jamarju/dump_spi_flash/cube/README.md

[STM32CubeMX](http://www.st.com/content/st_com/en/products/development-tools/software-development-tools/stm32-software-development-tools/stm32-configurators-and-code-generators/st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) project for my STM32F103C8T6 SPI NOR flash programmer.

Includes:

* Pinout
* Clock config

This was **not** used to generate the skeleton project, only to sketch out the pinout.
