jamarju/dump_spi_flash/cube/pin_assignment_screenshot.png

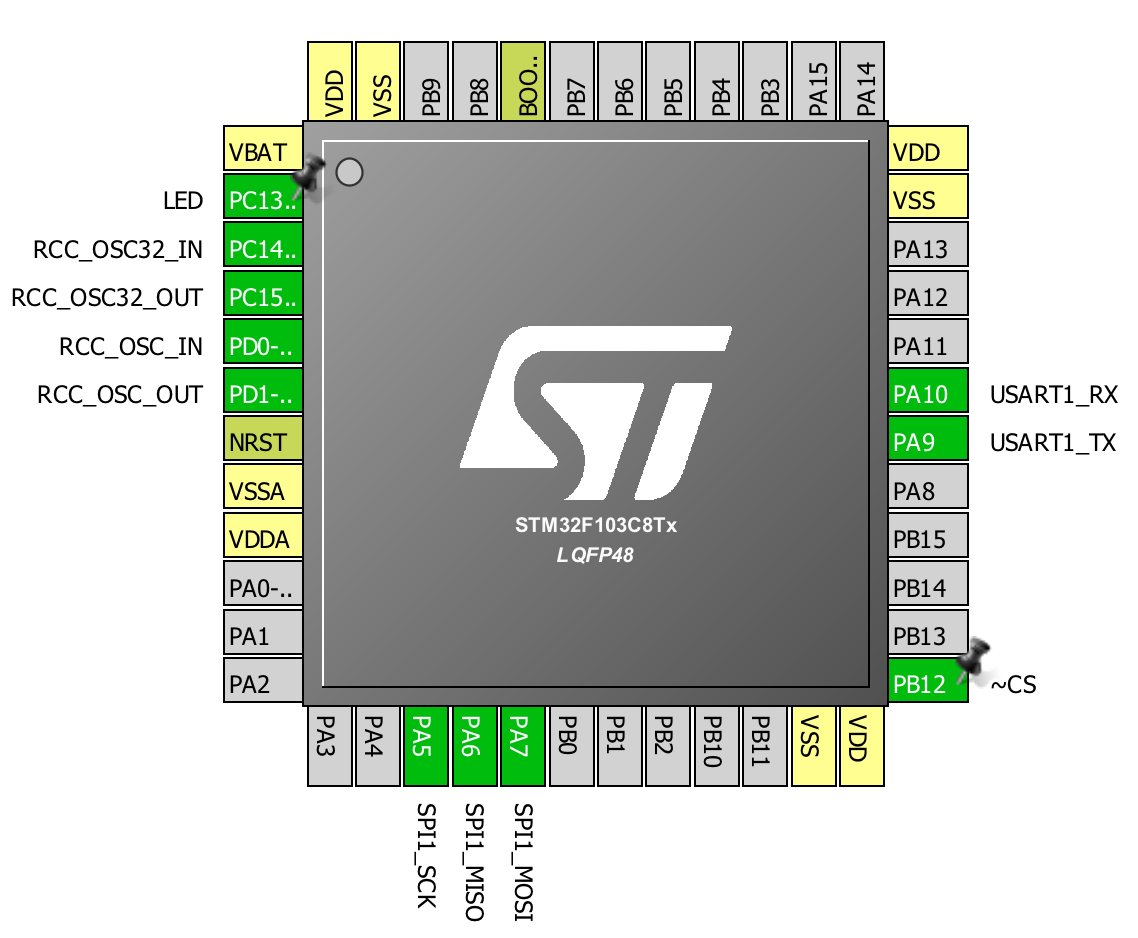
cube/pin_assignment_screenshot.png
