jamarju/dump_spi_flash/photos/ghetto_prog_02.jpg

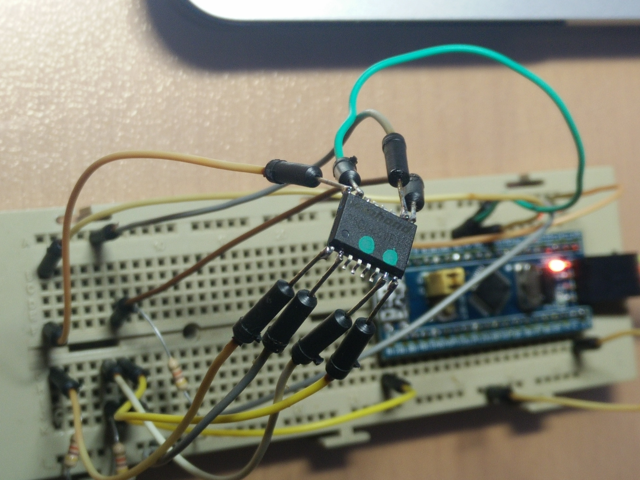
photos/ghetto_prog_02.jpg
