jamarju/dump_spi_flash/schematic/25Q64CVFIG programmer.sch

## KiCad design schematic/25Q64CVFIG programmer.sch (2016-08-23)

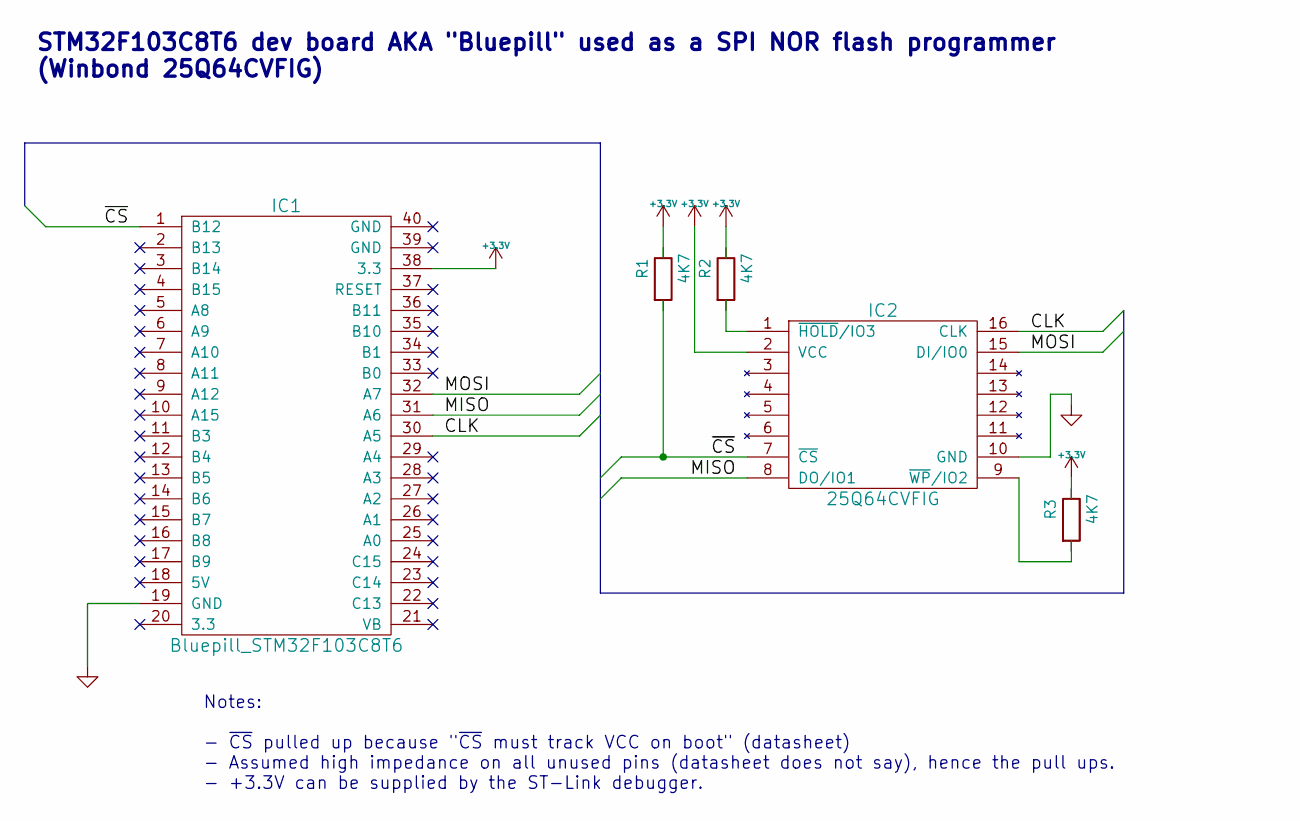
[picture p7: schematic 25Q64CVFIG programmer.sch]

Parts:
IC1: Bluepill_STM32F103C8T6
IC2: 25Q64CVFIG
R1, R2, R3: 4K7

Connections:
+3.3V: IC1.38 (3.3), IC2.2 (VCC)
CLK: IC1.30 (A5), IC2.16 (CLK)
GND: IC1.19 (GND), IC2.10 (GND)
MISO: IC1.31 (A6), IC2.8 (DO/IO1)
MOSI: IC1.32 (A7), IC2.15 (DI/IO0)
~CS: IC1.1 (B12), IC2.7 (~CS)

Notes on the sheet:
Notes: - ~CS~ pulled up because "~CS~ must track VCC on boot" (datasheet) - Assumed high impedance on all unused pins (datasheet does not say), hence the pull ups. - +3.3V can be supplied by the ST-Link debugger.
STM32F103C8T6 dev board AKA "Bluepill" used as a SPI NOR flash programmer (Winbond 25Q64CVFIG)
