jamarju/dump_spi_flash/(commit log)

2016-08-23 SPI NOR flash dumper eclipse project
2016-08-23 bluepill programmer kicad schematic + svg
    [25Q64CVFIG programmer.sch]
2016-08-23 added stm32f10x_spi.c to the Release config + .gitignore /Release
2016-08-23 added openocd and auxiliary scripts
    [stm32-bluepill.cfg]
2016-08-23 added stm32cubemx project (pinout and clock sketch)
